AladdinBensaid/Aladdin_Flight_Controller/bottom_layer.png

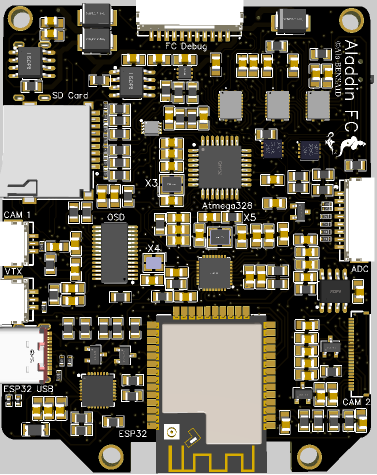
bottom_layer.png
