AladdinBensaid/Aladdin_Flight_Controller/block diagram.png

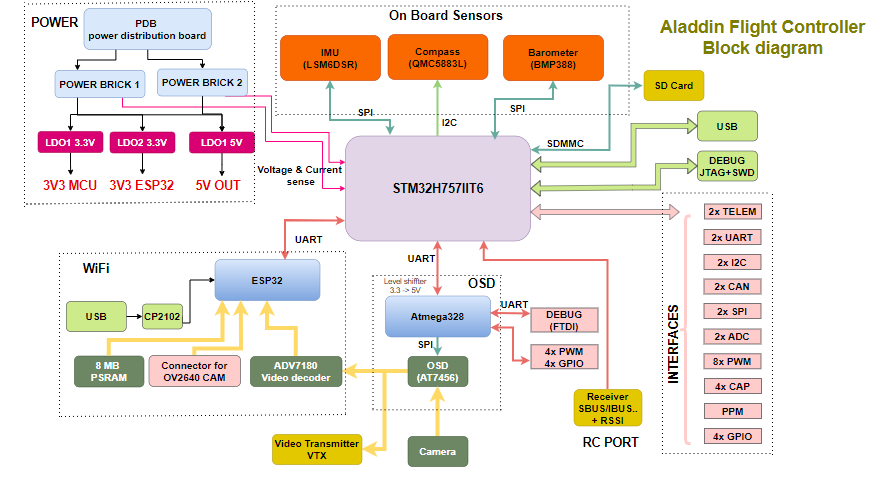
block diagram.png
