AladdinBensaid/Aladdin_Flight_Controller/top_layer.png

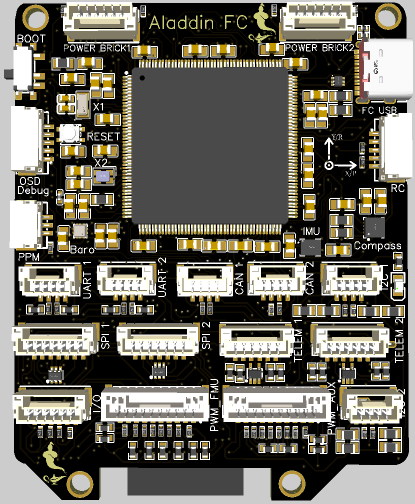
top_layer.png
