AladdinBensaid/Aladdin_Flight_Controller/BOM/BOM_Aladdin Flight Controller FC-H7_2023-02-08.csv

ID | Name | Designator | Footprint | Quantity | Manufacturer Part | Manufacturer | Supplier | Supplier Part | Price | link
1 | 100nF | C1,C2,C3,C4,C5,C6,C7,C8,C9,C10,C11,C12,C13,C14,C15,C16,C17,C18,C20,C21,C27,C28,C33,C36,C37,C38,C39,C40,C41,C45,C46,C47,C48,C51,C52,C53,C54,C56,C58,C59,C65,C68,C71,C72,C73,C74,C75,C89,C90,C91,C92,C93,C94,C95 | C0805 | 54 | CL21B104KBCNNNC | SAMSUNG | LCSC | C1711 | 0.001
2 | 4.7uF | C19,C22,C34 | C0805 | 3 | CL21B475KAFNNNE | SAMSUNG | LCSC | C98195 | 0.004
3 | 2.2uF | C23,C25 | C0805 | 2 | CS2012X5R225K500NRE | Samwha Capacitor | LCSC | C513763 | 0.004
4 | 1uF | C24,C26,C60,C61,C62,C67,C70,C86,C88 | C0805 | 9 | UMK212BJ105KG-T | Taiyo Yuden | LCSC | C319195 | 0.006
5 | 15pF | C29,C30 | C0603 | 2 | CL10C150JB8NNNC | SAMSUNG | LCSC | C1644 | 0.001
6 | 8pF | C31,C32 | C0805 | 2 | CL21C080DBANNNC | Samsung Electro-Mechanics | LCSC | C170111 | 0.006
7 | 220nF | C35 | C0805 | 1 | CC0805ZRY5V8BB224 | YAGEO | LCSC | C327192 | 0.004
8 | 10uF | C42,C55 | C0805 | 2 | TMK212BBJ106KGHT | Taiyo Yuden | LCSC | C386084 | 0.005
9 | 4pF | C43,C44 | C0805 | 2 | TCC0805C0G4R0C500BT | CCTC | LCSC | C282704 | 0.001
10 | 47uF | C49,C50 | C0805 | 2 | JMK212BJ476MG-T | TAIYO YUDEN | LCSC | C87159 | 0.006
11 | 15pF | C57 | C0805 | 1 | 0805CG150J500NT | FH | LCSC | C63339 | 0.001
12 | 47pF | C63,C64,C85 | C0805 | 3 | GCM21A5C2E470JX01D | muRata(村田) | LCSC | C440149 | 0.016 | https://atta.szlcsc.com/upload/public/pdf/source/20191022/C440149_79910CCEBA1A5070D97A60AC043D8869.pdf
13 | 82nF | C66 | C0805 | 1 | CC0805JRX7R9BB823 | YAGEO | LCSC | C520047 | 0.002
14 | 10nF | C69,C76,C77,C78,C79,C80 | C0805 | 6 | CC0805KRX7R9BB103 | YAGEO | LCSC | C83170 | 0.001
15 | 2.2uF | C81,C82,C83,C84 | C0805 | 4 | CC0805ZRY5V7BB225 | YAGEO | LCSC | C107171 | 0.005
16 | 22uF | C96 | C0805 | 1 | CL21A226MAQNNNE | SAMSUNG(三星) | LCSC | C45783 | 0.004
17 | XKTF-N02-G | CARD2 | TF-SMD_XKTF-N02-G | 1 | XKTF-N02-G | XKB Connectivity | LCSC | C1121875 | 0.025
18 | A1257WV-S-7P | CN1,CN2 | CONN-SMD_A1257WV-S-7P | 2 | A1257WV-S-7P | Changjiang Connectors | LCSC | C225123 | 0.038
19 | A1257WV-S-6P | CN3,CN4,CN5,CN15,CN17 | CONN-SMD_A1257WV-S-6P | 5 | A1257WV-S-6P | CJT(长江连接器) | LCSC | C225122 | 0.031
20 | A1257WV-S-4P | CN6,CN7,CN8,CN9,CN10,CN11 | CONN-SMD_A1257WV-S-4P | 6 | A1257WV-S-4P | CJT(长江连接器) | LCSC | C225120 | 0.019
21 | GH125-S10CCA-00 | CN14,CN16 | CONN-SMD_10P-P1.25_JS_GH125-S10CCA-00 | 2 | GH125-S10CCA-00 | JS(钜硕电子) | LCSC | C2886788 | 0.022
22 | A1257WR-S-3P | CN18,CN19,CN21 | CONN-SMD_A1257WR-S-3P | 3 | A1257WR-S-3P | Changjiang Connectors | LCSC | C225126 | 0.019
23 | A1257WR-S-5P | CN20,CN22 | CONN-SMD_A1257WR-S-5P | 2 | A1257WR-S-5P | Changjiang Connectors | LCSC | C225128 | 0.023
24 | A1257WR-S-8P | CN24 | CONN-SMD_A1257WR-S-8P | 1 | A1257WR-S-8P | CJT(长江连接器) | LCSC | C225131 | 0.031
25 | ST34BF | D1,D3,D14 | SMBF_L4.3-W3.6-LS5.3-RD | 3 | ST34BF | MDD（Microdiode Electronics） | LCSC | C414005 | 0.017
26 | SP1001-05JTG | D4,D5 | SC-70-6_L2.2-W1.3-P0.65-LS2.1-BL | 2 | SP1001-05JTG | Littelfuse | LCSC | C207268 | 0.112
27 | ESD9X5V-2/TR | D6,D7,D8,D9,D10,D11,D12,D13,D15,D18,D19,D20,D21,D22,D23,D24,D25,D26,D27,D28,D29,D30,D31,D32,D33,D34,D35,D36,D37,D38,D39,D40,D41,D42,D43,D44,D45,D46,D47,D48,D49,D50,D51,D52,D53,D54,D55,D56,D57,D58,D59,D60,D61,D62,D63,D64,D65 | FBP-02C_L1.0-W0.6-RD | 57 | ESD9X5V-2/TR | Will Semicon | LCSC | C239552 | 0.004
28 | SP1001-04JTG | D16,D17 | SC-70-5_L2.1-W1.3-P0.65-LS2.2-BR | 2 | SP1001-04JTG | Littelfuse | LCSC | C207267 | 0.073
29 | 0.5K-HX-24PWB | FPC1 | FPC-SMD_24P-P0.50_HDGC_0.5K-HX-24PWB | 1 | 0.5K-HX-24PWB | HDGC(华德共创) | LCSC | C2919499 | 0.045
30 | FCM1005KF-601T03 | L1 | L0402 | 1 | FCM1005KF-601T03 | TAI-TECH(台庆) | LCSC | C427432
31 | SZYY0805B | LED1 | LED0805-R-RD_BLUE | 1 | SZYY0805B | yongyu(永裕光电) | LCSC | C434433 | 0.002
32 | S8050_C105433 | Q3,Q4 | SOT-23-3_L2.9-W1.6-P1.90-LS2.8-BR | 2 | S8050 | CJ | LCSC | C105433 | 0.002
33 | 10kΩ | R1,R9,R21,R25,R26,R30,R31,R37,R38,R63 | R0805 | 10 | ARG05BTC1002 | Viking Tech | LCSC | C406725 | 0.004
34 | 2.2kΩ | R2,R3 | R0805 | 2 | AR05BTB2201 | Viking Tech | LCSC | C374634 | 0.019
35 | 100kΩ | R4,R5,R6,R7,R8,R39,R43,R44 | R0805 | 8 | ARG05BTC1003 | Viking Tech | LCSC | C406726 | 0.005
36 | 1kΩ | R10,R11,R12,R24,R28,R29 | R0805 | 6 | ARG05BTC1001 | Viking Tech | LCSC | C309081 | 0.005
37 | 75Ω | R13,R14 | R0805 | 2 | AR05BTDW0750 | Viking Tech | LCSC | C319469 | 0.007
38 | 200kΩ | R15 | R0805 | 1 | AR05BTDW2003 | Viking Tech | LCSC | C319784 | 0.006
39 | 4.7kΩ | R16,R17,R18,R27,R36,R64 | R0805 | 6 | RMC08054.7K1%N | Tyohm | LCSC | C269746 | 0.001
40 | 5.1kΩ | R19,R20,R47,R48 | R0402 | 4 | RMC04025.1K5%N | Tyohm | LCSC | C325524
41 | 1MΩ | R22 | R0805 | 1 | AR05BTCW1004 | Viking Tech | LCSC | C316223 | 0.006
42 | 1.69kΩ | R23 | R0805 | 1 | ARG05FTC1691 | Viking Tech | LCSC | C218401 | 0.002
43 | 4kΩ | R32 | R0805 | 1 | ARG05FTC4001N | 光颉(Viking) | LCSC | C2828855 | 0.001
44 | 0Ω | R33,R42,R62,R65,R86,R88,R89,R90,R91 | R0805 | 9 | 0805W8F0000T5E | UniOhm | LCSC | C17477
45 | 36Ω | R34 | R0805 | 1 | AECR0805F36R0K9 | ResistorToday | LCSC | C352217 | 0.001
46 | 39 | R35 | R0805 | 1 | AC0805JR-0739RL | YAGEO | LCSC | C229199 | 0.001
47 | 50Ω | R40 | R0805 | 1 | ARG05FTC0500 | 光颉(Viking) | LCSC | C2828866 | 0.002
48 | 300kΩ | R41,R92 | R0805 | 2 | ERJ6GEYJ304V | PANASONIC | LCSC | C410067 | 0.001
49 | 120 | R45,R46 | R0805 | 2 | AC0805FR-07120RL | YAGEO | LCSC | C228277 | 0.001
50 | 1.5K | R49,R50,R51,R52 | R0805 | 4 | CR0805-FX-1501ELF | BOURNS | LCSC | C203762 | 0.002
51 | 22 | R53,R54,R55,R56 | R0805 | 4 | CR0805-FX-22R0ELF | BOURNS | LCSC | C204317 | 0.002
52 | 100Ω | R57,R58,R59,R60,R61,R66,R67,R68,R69,R70,R71,R72,R73,R74,R75,R76,R77,R78,R79,R80,R81,R82,R83,R84,R85 | R0603 | 25 | FRC0603J101 TS | FOJAN(富捷) | LCSC | C2907089
53 | RC0805DR-0780K6L | R93 | R0805 | 1 | RC0805DR-0780K6L | YAGEO(国巨) | LCSC | C472215 | 0.002
54 | TS-3027-B | SW1 | SW-SMD_4P-L3.0-W2.8-P1.65-TL_GT-TS171A-H014-L1 | 1 | TS-3027-B | XKB Enterprise | LCSC | C561482 | 0.025
55 | MK-12C02-G025 | SW2 | SW-SMD_MK-12C02-G025 | 1 | MK-12C02-G025 | G-Switch | LCSC | C778186 | 0.02
56 | STM32H757IIT6 | U1 | LQFP-176_L24.0-W24.0-P0.50-LS26.0-BL | 1 | STM32H757IIT6 | STMicroelectronics | LCSC | C730215 | 4.025
57 | BMP388 | U2 | SENSORM-SMD_BMP388 | 1 | BMP388 | null | LCSC | C779278 | 0.437
58 | QMC5883L | U3 | LGA-16_L3.0-W3.0-P0.50-BL_SQ | 1 | QMC5883L | QST(上海矽睿) | LCSC | C976032 | 0.22
59 | LSM6DSOWTR | U4 | LGA-14L_L3.0-W2.5-P0.50-TL | 1 | LSM6DSOWTR | ST(意法半导体) | LCSC | C2829074 | 0.442 | https://atta.szlcsc.comnull
60 | ATMEGA328P-AU | U5 | TQFP-32_L7.0-W7.0-P0.80-LS9.0-BL | 1 | ATMEGA328P-AU | MICROCHIP | LCSC | C14877 | 0.481
61 | AT7456E | U6 | TSSOP-28_L9.7-W4.4-P0.65-LS6.4-BL-EP-2 | 1 | AT7456E | ZHONGKEWEI | LCSC | C82351 | 0.48
62 | PCA9306DCUR | U7 | SSOP-8_L2.0-W2.3-P0.50-LS3.1-BR | 1 | PCA9306DCUR | TI | LCSC | C33196 | 0.05
63 | ME6211A12M3G-N | U8 | SOT-23-3_L2.9-W1.6-P1.90-LS2.8-BR | 1 | ME6211A12M3G-N | Nanjing Micro One Elec | LCSC | C236678 | 0.011
64 | LY68L6400SLIT | U9 | SOP-8_L4.9-W3.9-P1.27-LS6.0-BL | 1 | LY68L6400SLIT | Lyontek Inc. | LCSC | C261881 | 0.478
65 | USB-TYPE-C-017 | U10,U23 | USB-TYPE-C-SMD_C9900008089_ALA1 | 2 | USB-TYPE-C-017 | DEALON(德艺隆) | LCSC | C2927037 | 0.023 | https://atta.szlcsc.com/upload/public/pdf/source/20211217/653222EE5174722C9DFE2966329956D8.pdf
66 | XC6206-2.8V | U11 | SOT-23-3_L2.9-W1.6-P1.90-LS2.8-BR | 1 | XC6206-2.8V | YONGYUTAI(永裕泰) | LCSC | C2892669 | 0.008
67 | CP2102-GMR | U12 | WQFN-28_L5.0-W5.0-P0.50-BL-EP3.2 | 1 | CP2102-GMR | SILICON LABS | LCSC | C6568 | 0.39
68 | ESP32-S(8MB) | U13 | WIRELM-SMD_ESP32-S | 1 | ESP32-S(8MB) | Ai-Thinker(安信可) | LCSC | C2991922 |  | https://atta.szlcsc.com/upload/public/pdf/source/20211217/F4BEA33E732D6002D10DAED85BBCB52B.pdf
69 | MF-NSMF150-2 | U14 | F1206 | 1 | MF-NSMF150-2 | BOURNS | LCSC | C89655 | 0.006
70 | 65K5. | U15 | SOT-23-3_L2.9-W1.3-P1.90-LS2.4-BR | 1 | 65K5. | Shenzhen Fuman Elec | LCSC | C841299 | 0.008
71 | ADV7180BCP32Z-RL | U16 | LFCSP-32_L5.0-W5.0-P0.50-BL-EP3.6 | 1 | ADV7180BCP32Z-RL | Analog Devices | LCSC | C459884 | 0.533
72 | TJA1051TK/3,118 | U17,U21 | HVSON-8_L3.0-W3.0-P0.65-BL-EP | 2 | TJA1051TK/3,118 | NXP | LCSC | C124020 | 0.25
73 | LR1801G-33-SH2-R | U19,U20 | HSOP-8_L5.0-W4.0-P1.27-LS6.2-BL-EP | 2 | LR1801G-33-SH2-R | Unisonic Tech | LCSC | C410479 | 0.021
74 | NUF2042XV6T1G | U22 | SOT-563_L1.6-W1.2-P0.50-LS1.6-TL | 1 | NUF2042XV6T1G | ON Semicon | LCSC | C90707 | 0.08
75 | TPS25200DRVR | U24 | WSON-6_L2.0-W2.0-P0.65-TL-EP | 1 | TPS25200DRVR | TI | LCSC | C128401 | 0.128
76 | TXS0108ERGYR | U25,U26,U29 | VQFN-20_L4.6-W3.6-P0.50-BL-EP | 3 | TXS0108ERGYR | TI(德州仪器) | LCSC | C90706 | 0.403
77 | A1257WR-S-11P | U27 | CONN-SMD_A1257WR-S-11P | 1 | A1257WR-S-11P | Changjiang Connectors | LCSC | C272991 | 0.047
78 | 32.768kHz | X1 | OSC-SMD_2P-L3.2-W1.5 | 1 | CM315D32768DZFT | CITIZEN | LCSC | C182057 | 0.043
79 | 24MHz | X2 | OSC-SMD_4P-L2.0-W1.6-BL | 1 | TZ1620C | TST | LCSC | C498196 | 0.03
80 | 16MHz | X3 | CRYSTAL-SMD_4P-L3.2-W2.5-BL | 1 | X1E0003410273 | Seiko Epson | LCSC | C255906 | 0.076
81 | 27MHz | X4 | OSC-SMD_4P-L2.5-W2.0-BL | 1 | Q24FA20H00238 | Seiko Epson | LCSC | C255960 | 0.042
82 | 28.63636MHz | X5 | CRYSTAL-SMD_4P-L3.2-W2.5-BL | 1 | 7B028636R01 | HD | LCSC | C655017 | 0.016
