AladdinBensaid/Aladdin_Flight_Controller/3d parts/top_part_enclosure_3d.STL

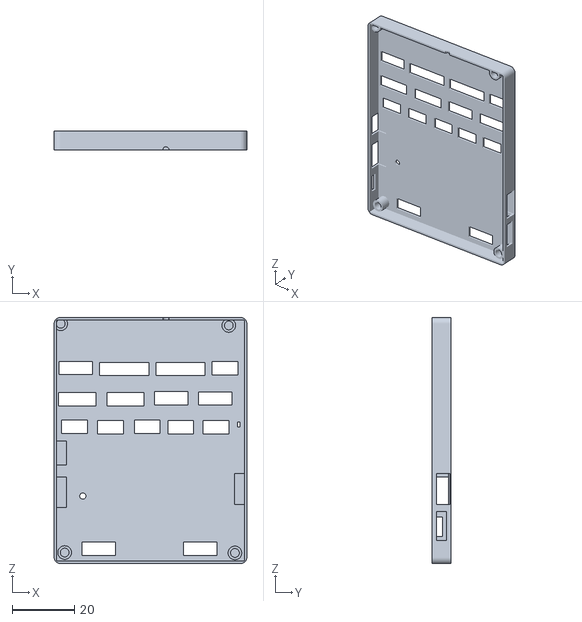
[picture p4: CAD file, 2023-04-13]
3d parts/top_part_enclosure_3d.STL
61.9 x 6.00 x 79.0
