AladdinBensaid/Aladdin_Flight_Controller/3d parts/bottom_part_enclosure.SLDPRT

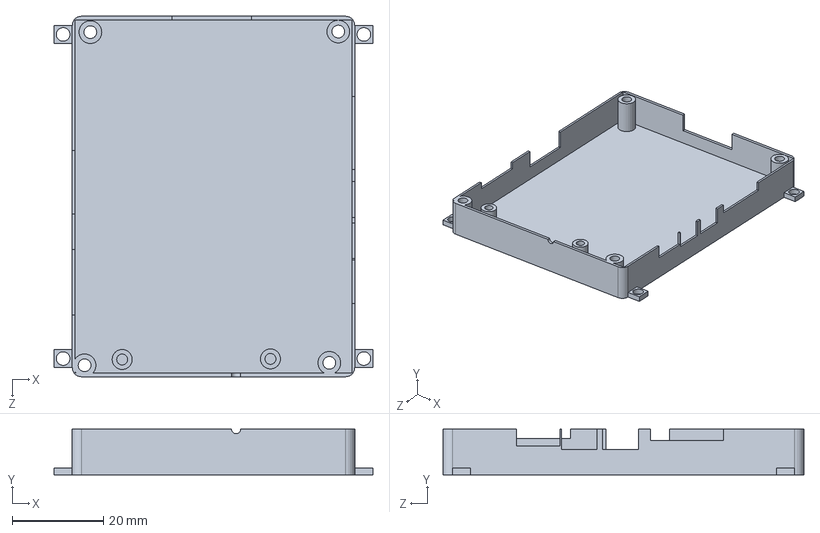
[picture p5: CAD file, 2023-04-13]
3d parts/bottom_part_enclosure.SLDPRT
69.9 x 10.0 x 79.1 mm
