AladdinBensaid/Aladdin_Flight_Controller/(list of files, cad)

Other CAD files:
3d parts/bottom_part_enclosure_3d.STL
3d parts/top_part_enclosure.SLDPRT
