AladdinBensaid/Aladdin_Flight_Controller/Aladdin_Flight_Controller_Manual.pdf

# Aladdin Flight Controller

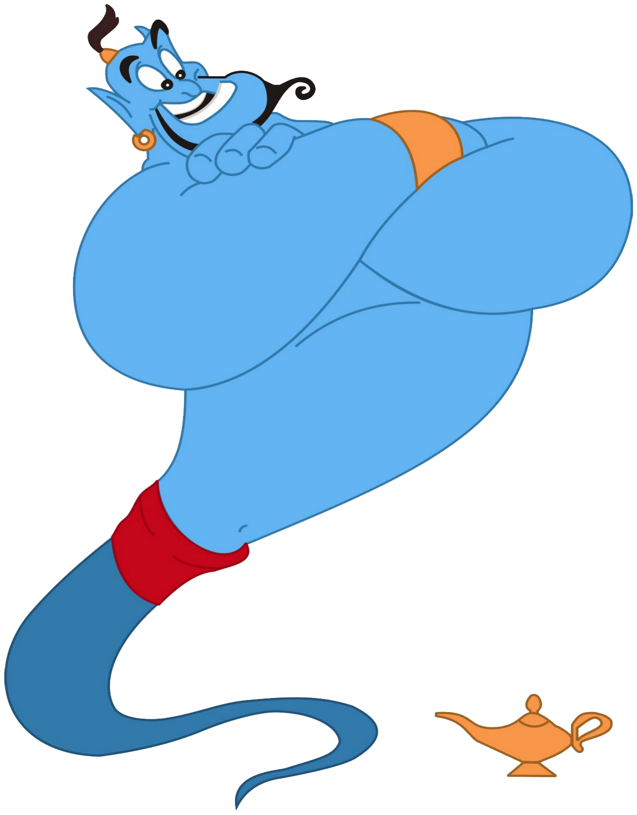
[picture p6: figure]

©Ala bensaid
Github : AladdinBensaid

Aladdin FC is an advanced STM32H7 autopilot designed by Ala bensaid.

Specifications :

Processor :
- Dual 32 bit ARM Cortex M7/M4 with double precision FPU (STM32H757)
- 480Mhz / 1 MB RAM / 2 MB Flash
- 8 bit IO MCU Co-Processor (Atmega328p)

Sensors :
- Barometer BMP388
- Magnetometer QMC5883L
- Accelerometer/Gyroscope LSM6DSOWTR

Power :
- USB input
- Operatory power 5V (dual power port)
- Dual voltage and current monitor inputs
- Adaptable with Pixhawk 4 power module PM07

Interfaces :
- 8-12 PWM output (8 FMU + 4 IO MCU) support DMA
- 2x CAN Bus
- 2x I2C Port
- 2x SPI Port
- 4x UART Port
- PPM Port
- RC Port Support all RC protocols including (SBUS/DSM/IBUS/PPM) + RSSI input
- 2x ADC pin
- I/O (4x GPIO)
- STM32 debug (JTAG + SWD + 1x UART) + USB interface
- IO MCU debug (1x UART)
- ESP32 USB interface

Others :
- Built in OSD
- SD Card (SDMMC protocol)
- ESP32 (8MB PSRAM) to support WiFi connectivity (live streaming / 4g,5g navigation …)
- Support Analog Camera (PAL/NTSC) + built in Analog to 8-bit video decoder
- Support OV2640 Camera
- Dimensions : 60.79mm x 76.71mm x 1.6mm
- JST GH connectors

Github Link for the project : https://github.com/AladdinBensaid/Aladdin_Flight_Controller

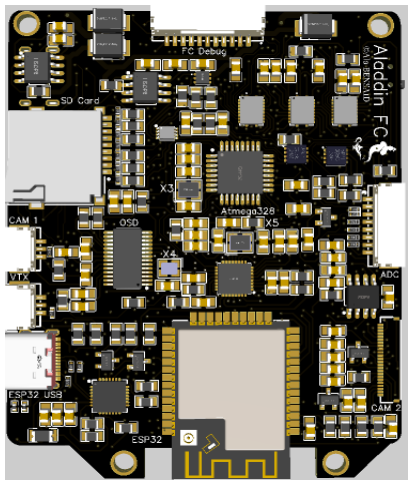
[picture p7: figure]
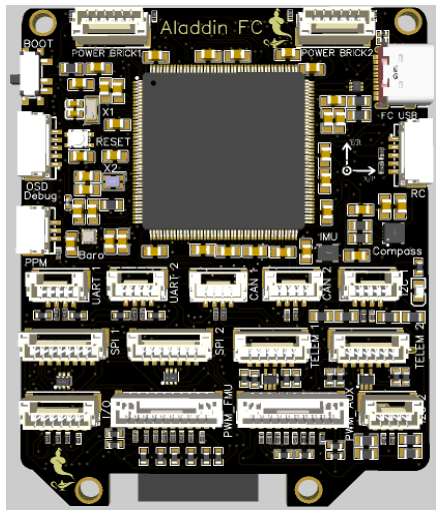
[picture p8: figure]

Top layer | Bottom layer

Aladdin FC Block Diagram

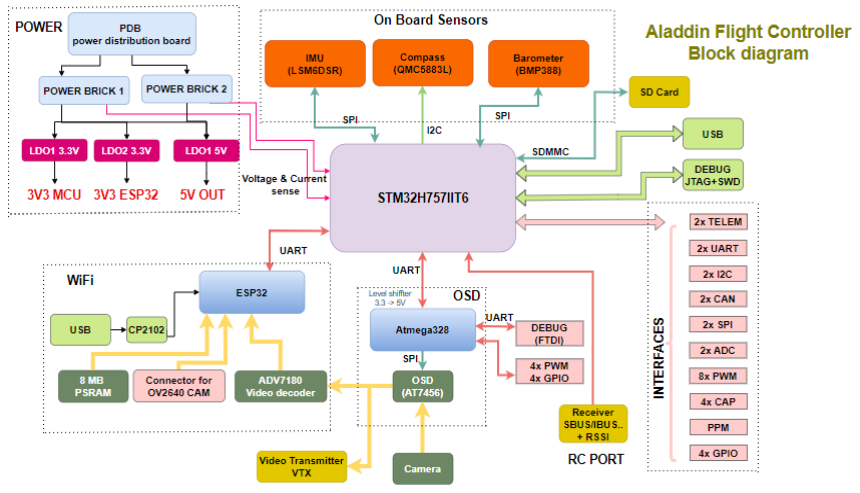
[picture p9: figure]

Connectors :
(Number of pin on board from left ->right / up -> down)
POWER BRICK 1 | POWER BRICK 2

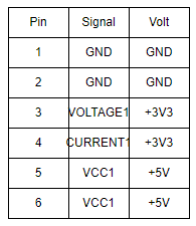
[picture p10: figure]
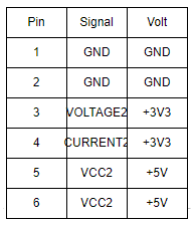
[picture p11: figure]
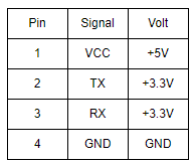
[picture p12: figure]
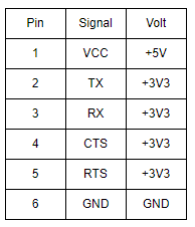
[picture p13: figure]

UART1 / UART2 | TELEM 1 / TELEM 2

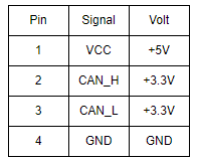
[picture p14: figure]
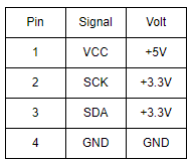
[picture p15: figure]

CAN 1/ CAN 2 | I2C 1 / I2C 2

SPI 1 / SPI 2

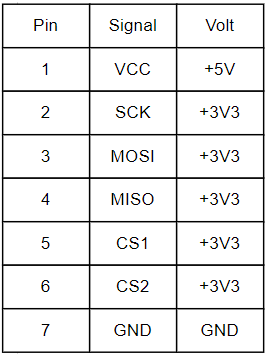
[picture p16: figure]
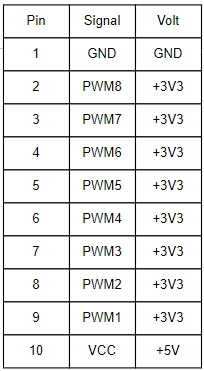
[picture p17: figure]
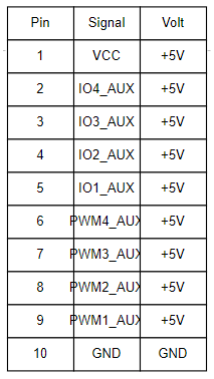
[picture p18: figure]

PWM FMU | PWM AUX

I/O

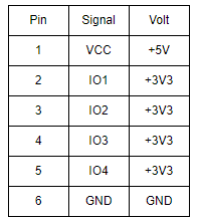
[picture p19: figure]
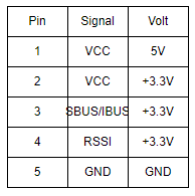
[picture p20: figure]
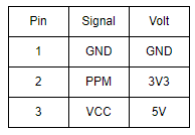
[picture p21: figure]

RC | PPM

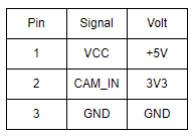
[picture p22: figure]
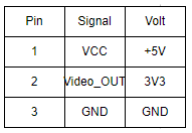
[picture p23: figure]

CAM | VTX

ADC | FC DEBUG

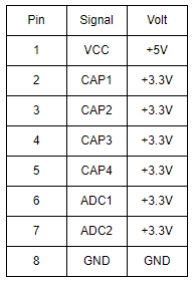
[picture p24: figure]

OSD DEBUG

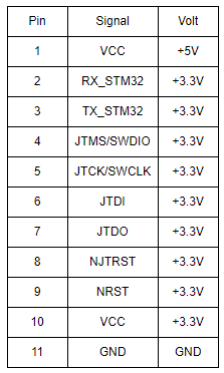
[picture p25: figure]
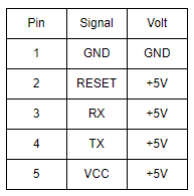
[picture p26: figure]

Aladdin FC schematics :

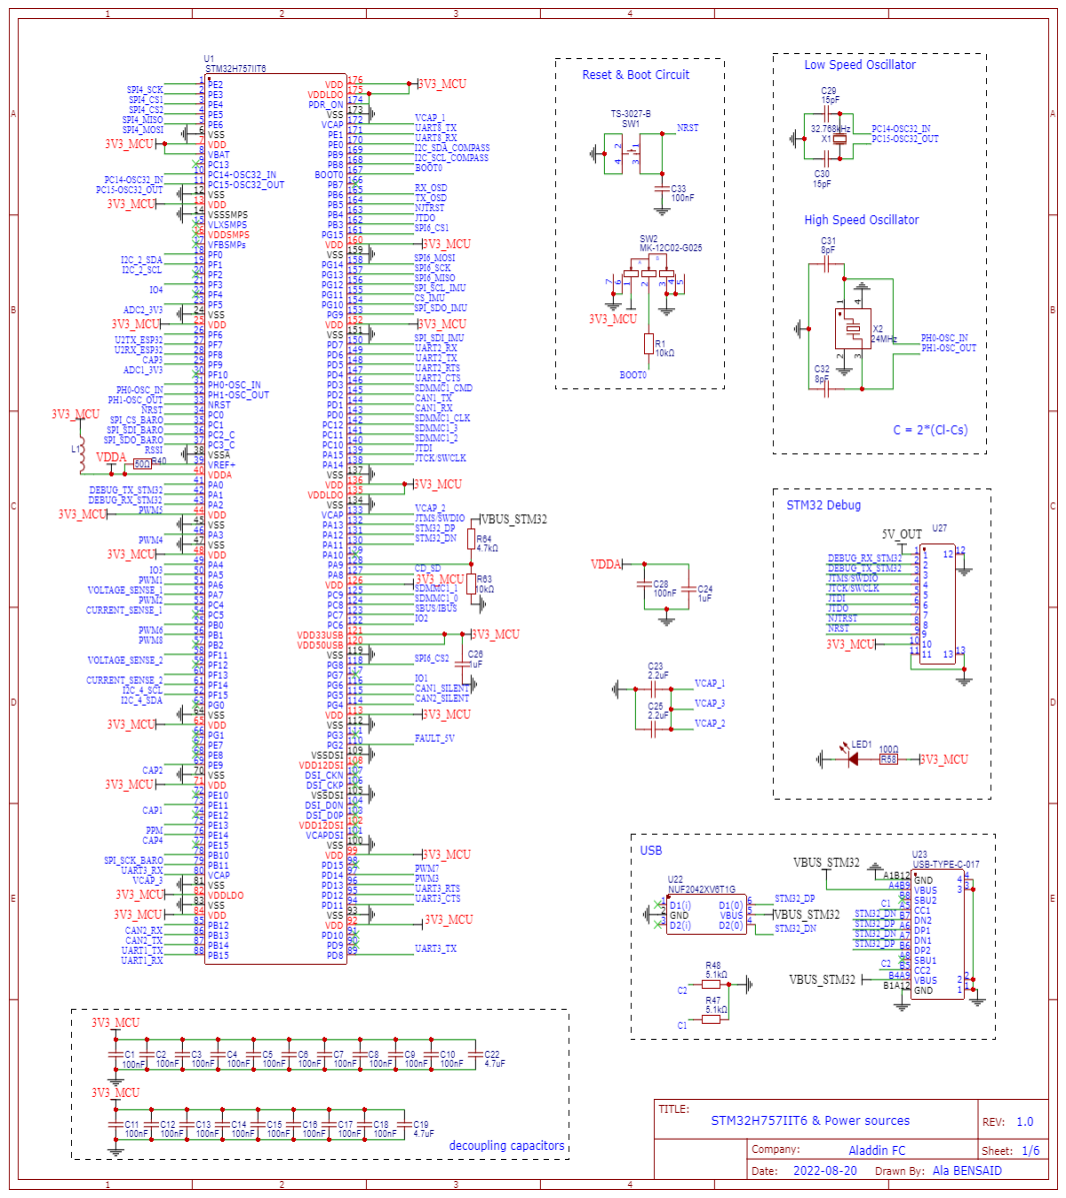
[picture p27: figure]
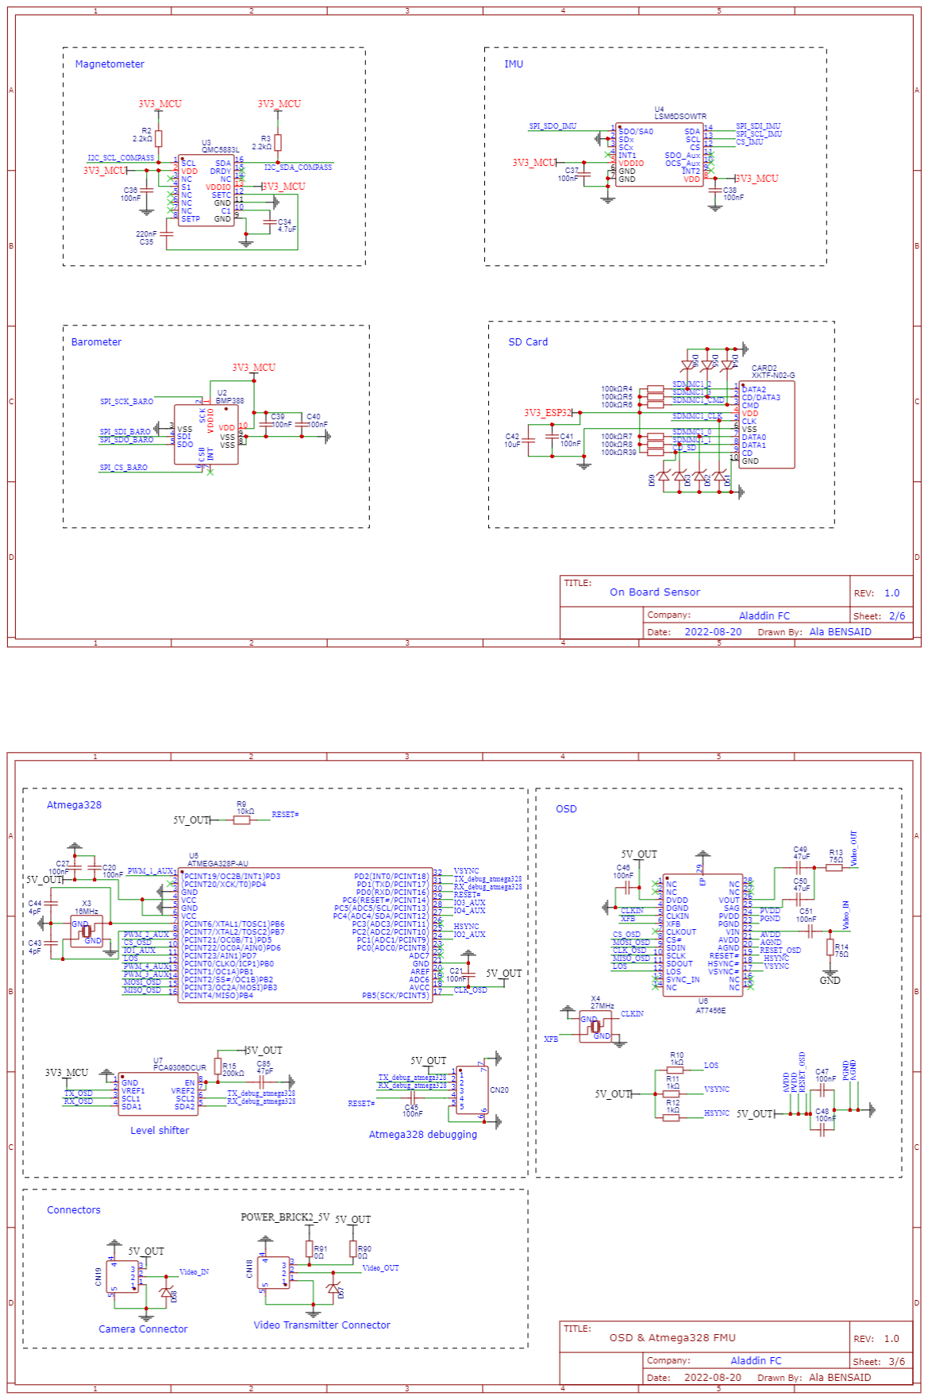
[picture p28: page 10]
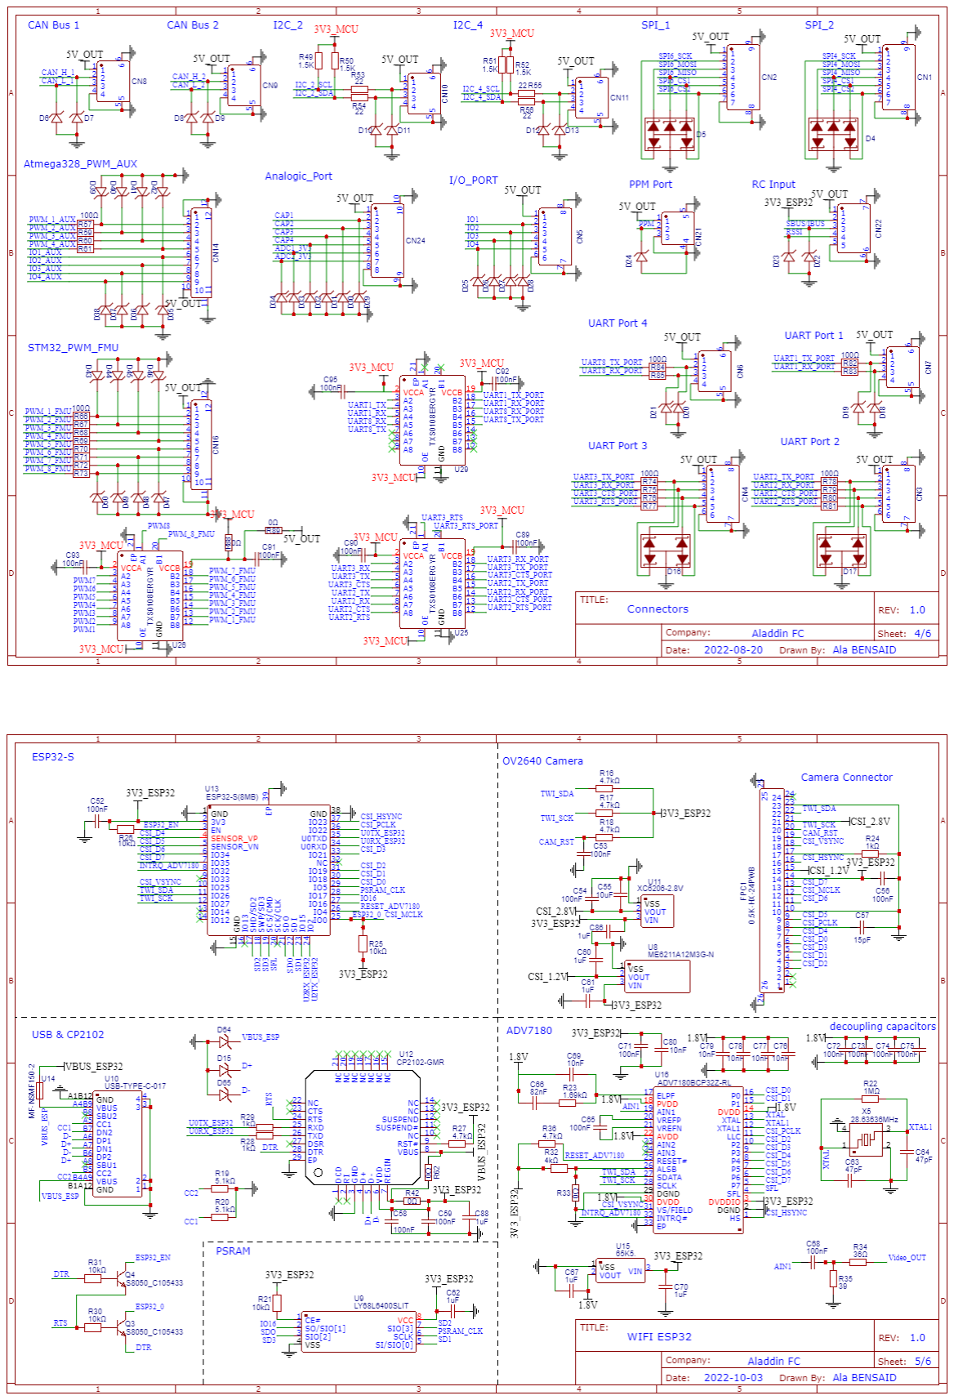
[picture p29: page 11]

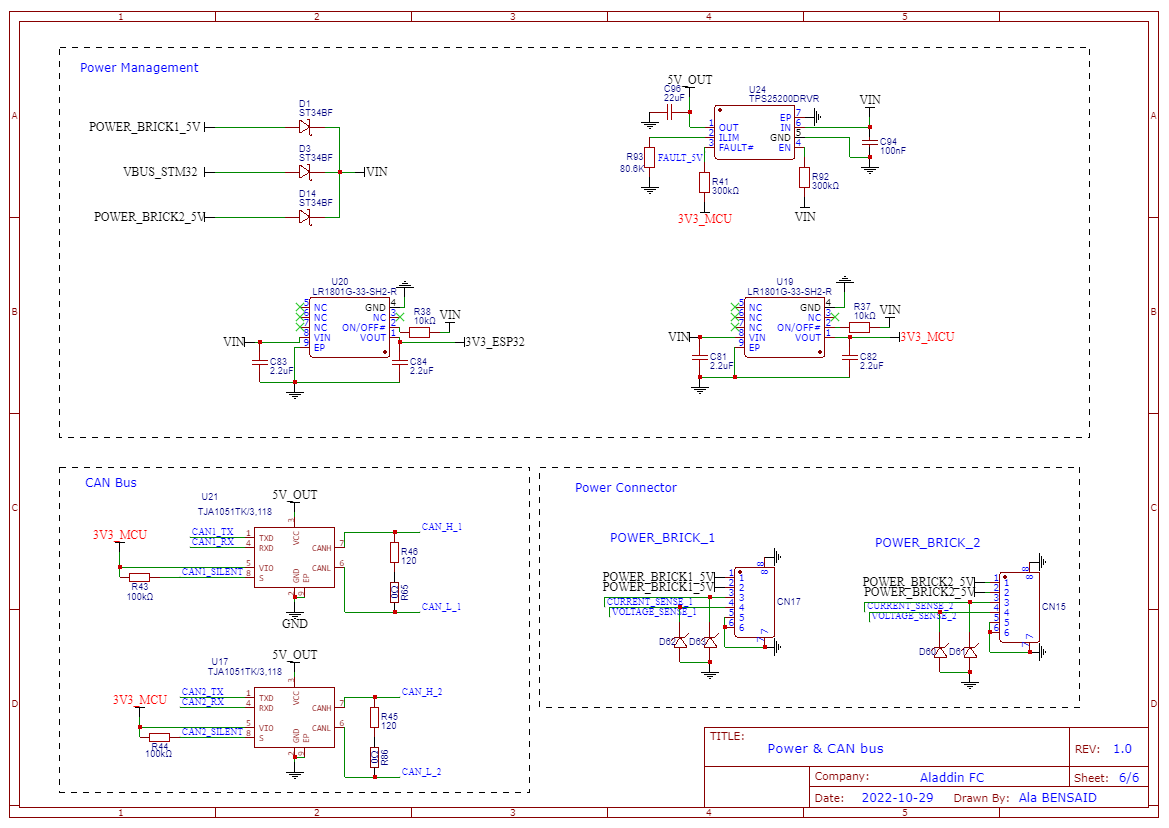
[picture p30: figure]

Aladdin FC is a 6 layers board with the following Stackup ;

1st layer (signals) + 2nd layer (GND Plane) + 3rd layer (signals + power) + 4th layer (signals) + 5th layer (GND plane) + 6th layer (signals)

1st layer (Top layer) layout :

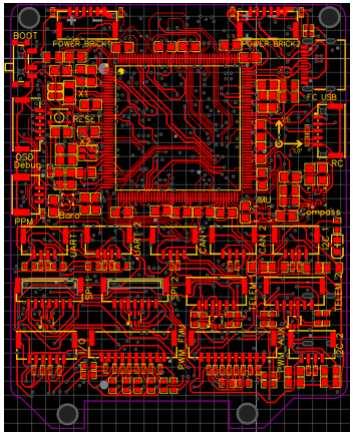
[picture p31: figure]

3rd layer layout

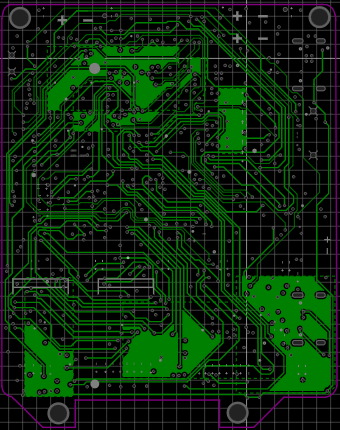
[picture p32: figure]

4th layer layout

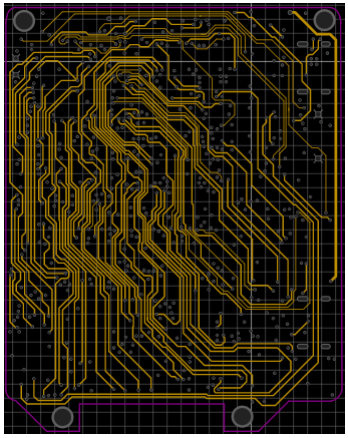
[picture p33: figure]

6th layer (Bottom layer) layout :

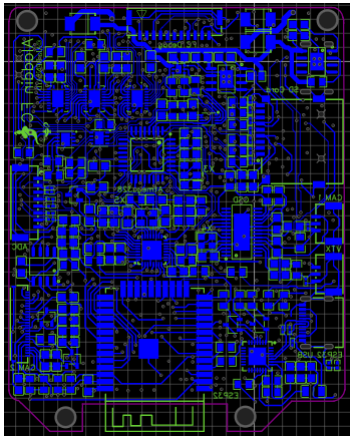
[picture p34: figure]
