AladdinBensaid/Aladdin_Flight_Controller/3d parts/assembly_pic.png

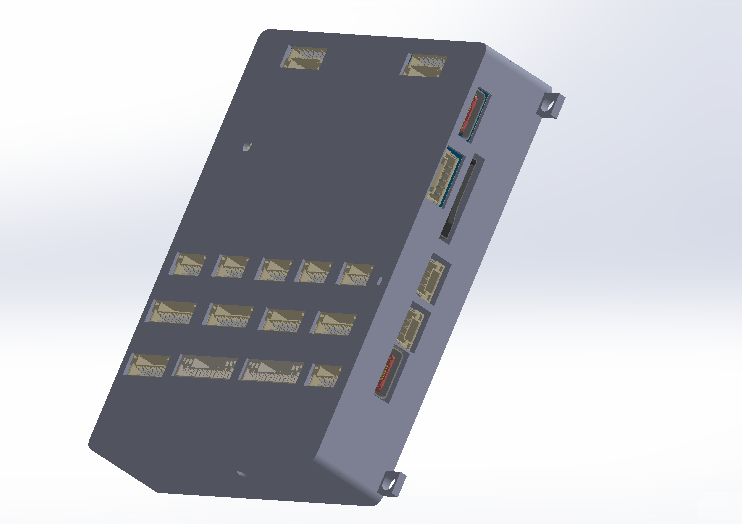
3d parts/assembly_pic.png
