AladdinBensaid/Aladdin_Flight_Controller/Schematic_Aladdin Flight Controller FC-H7.pdf

PB15 88 PD8 89 PD9 90 PD10 91 VDD 92 VSS 93 PD11 94 PD12 95 PD13 96 PD14 97 PD15 98 VDD 99 VSS 100 VCAPDSI 101 VDD12DSI 102 DSI_D0P 103 DSI_D0N 104 VSSDSI 105 DSI_CKP 106 DSI_CKN 107 VDD12DSI 108 VSSDSI 109 PG2 110 PG3 111 VSS 112 VDD 113 PG4 114 PG5 115 PG6 116 PG7 117 PG8 118 VSS 119 VDD50USB 120 VDD33USB 121 PC6 122 PC7 123 PC8 124 PC9 125 VDD 126 PA8 127 PA9 128 PA10 129 PA11 130 PA12 131 PA13 132 VCAP 133 VSS 134 VDDLDO 135 VDD 136 VSS 137 PA14 138 PA15 139 PC10 140 PC11 141 PC12 142 PD0 143 PD1 144 PD2 145 PD3 146 PD4 147 PD5 148 PD6 149 PD7 150 VSS 151 VDD 152 PG9 153 PG10 154 PG11 155 PG12 156 PG13 157 PG14 158 VSS 159 VDD 160 PG15 161 PB3 162 PB4 163 PB5 164 PB6 165 PB7 166 BOOT0 167 PB8 168 PB9 169 PE0 170 PE1 171 VCAP 172 VSS 173 PDR_ON 174 VDDLDO 175 VDD 176

## Reset & Boot Circuit

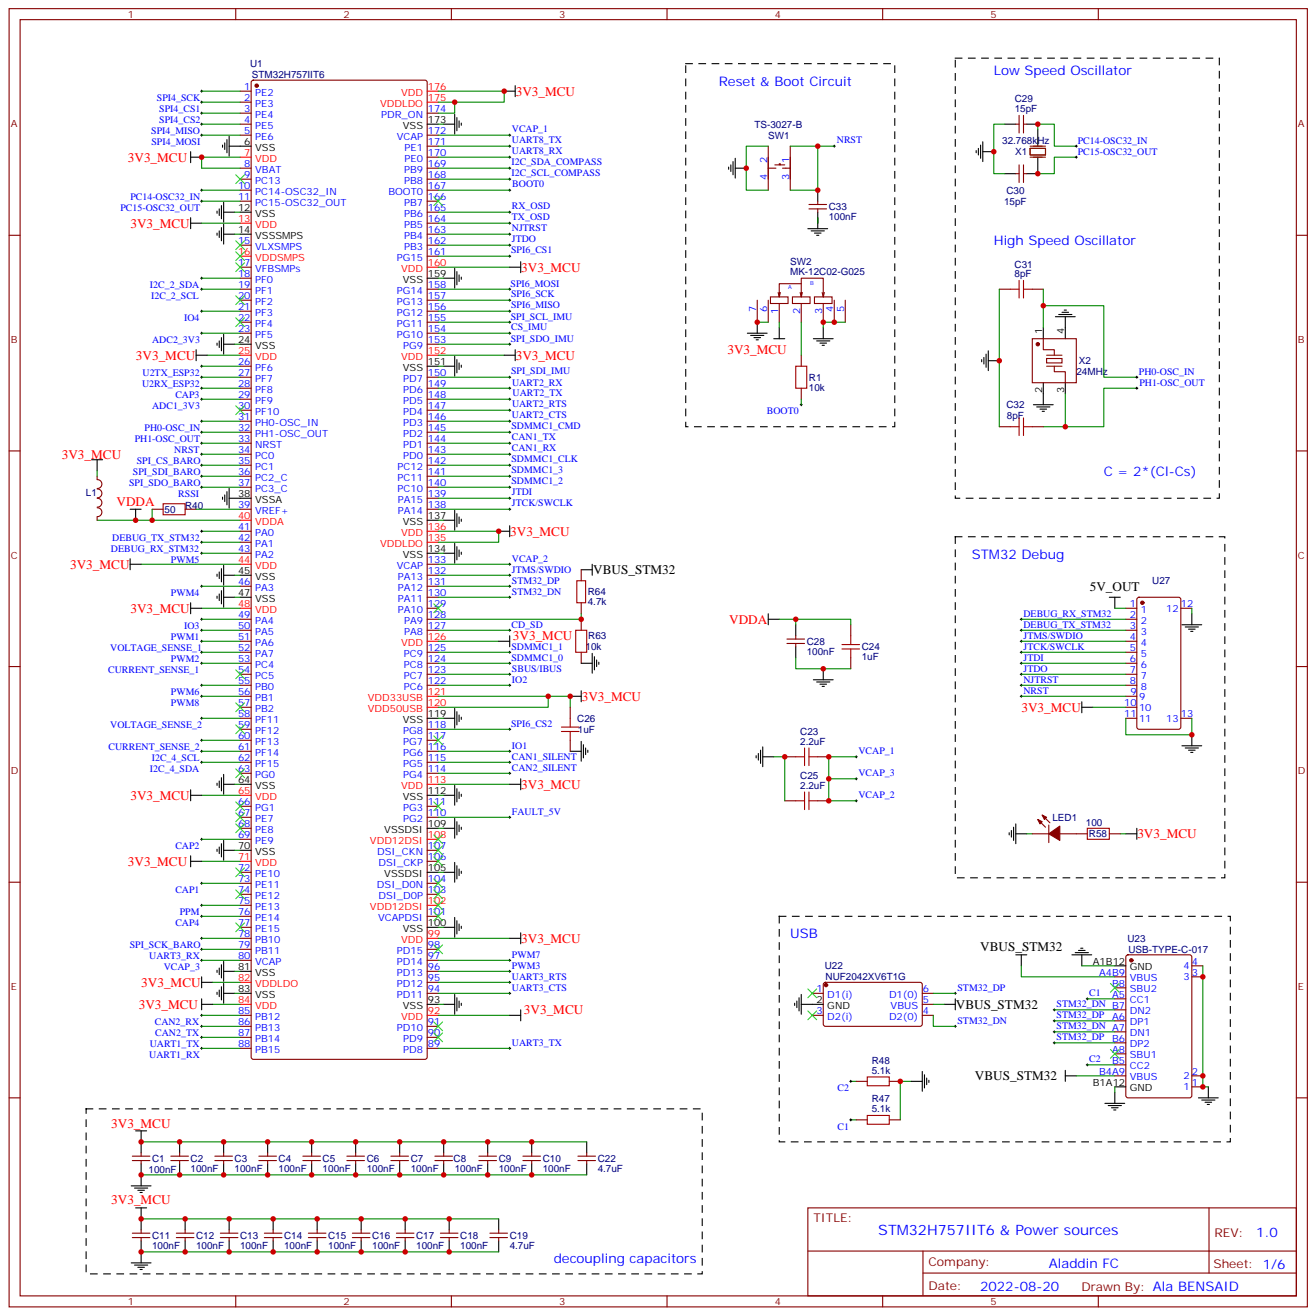
[picture p36: page 1]

Aladdin FC
Drawn By: Ala BENSAID

## Magnetometer

## IMU

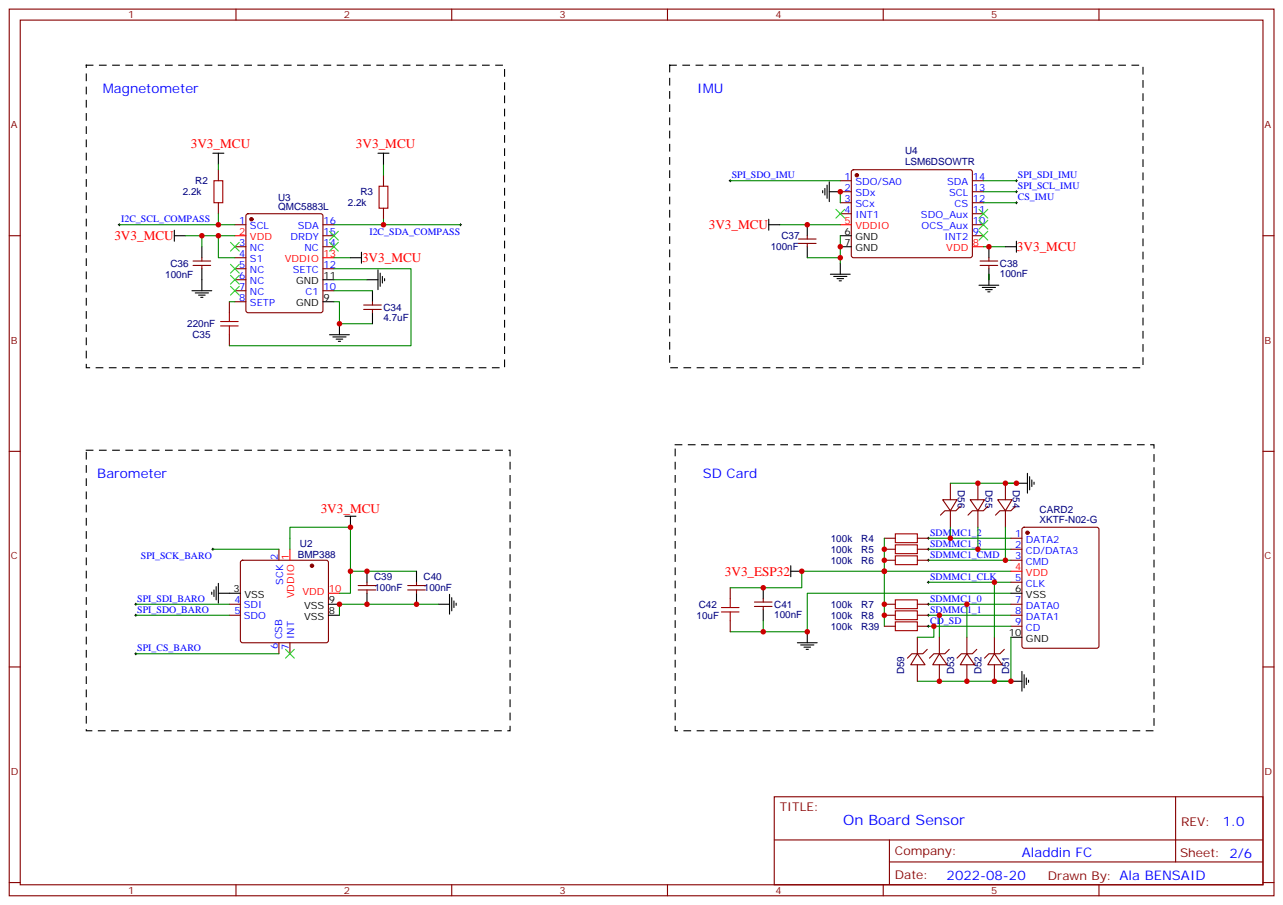
[picture p37: page 2]

QMC5883L
C1 10 GND 11 SETC 12 VDDIO 13 NC 14 DRDY 15 SDA 16

## OSD

## Atmega328

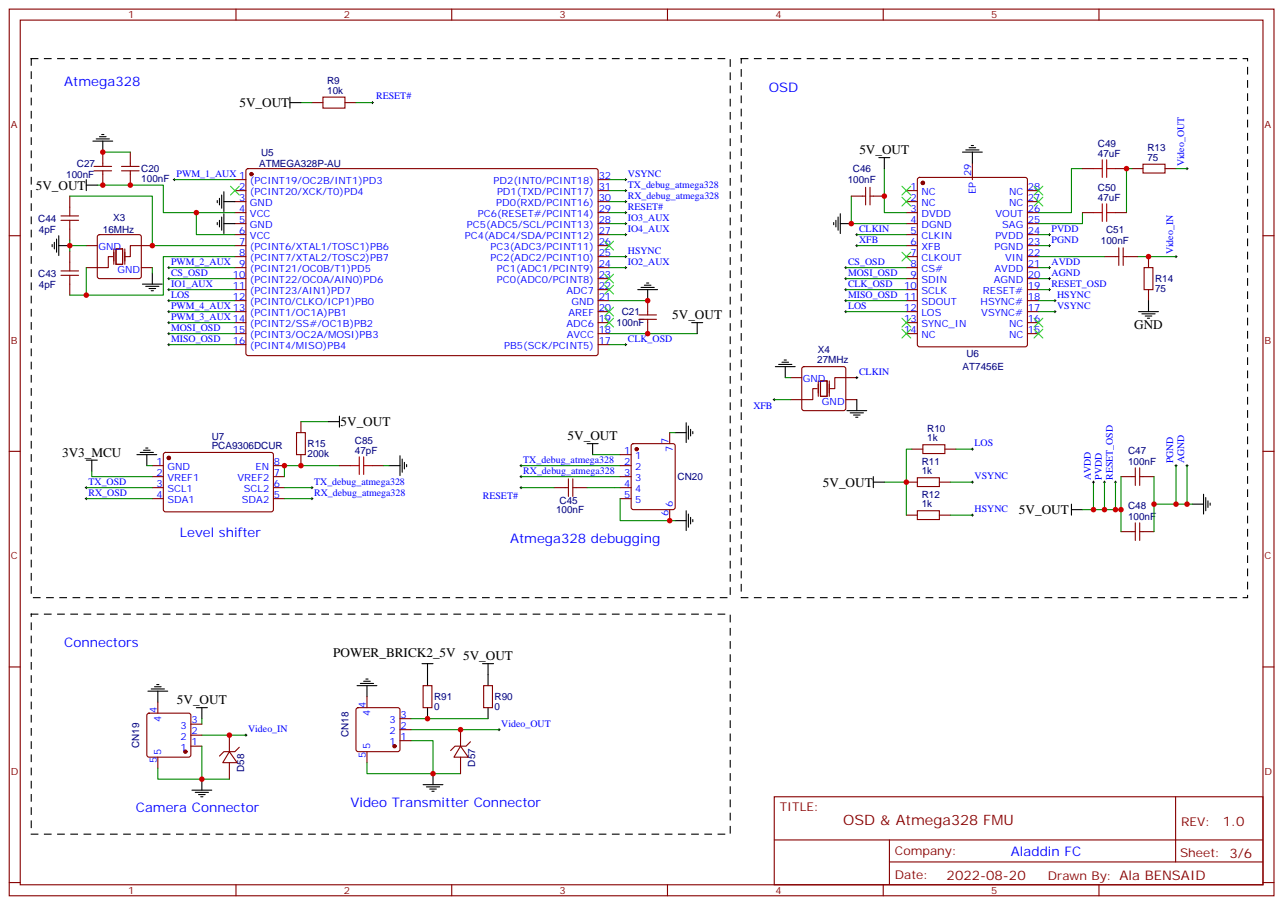
[picture p38: page 3]

CAN Bus 1 | CAN Bus 2
I2C_2 | I2C_4

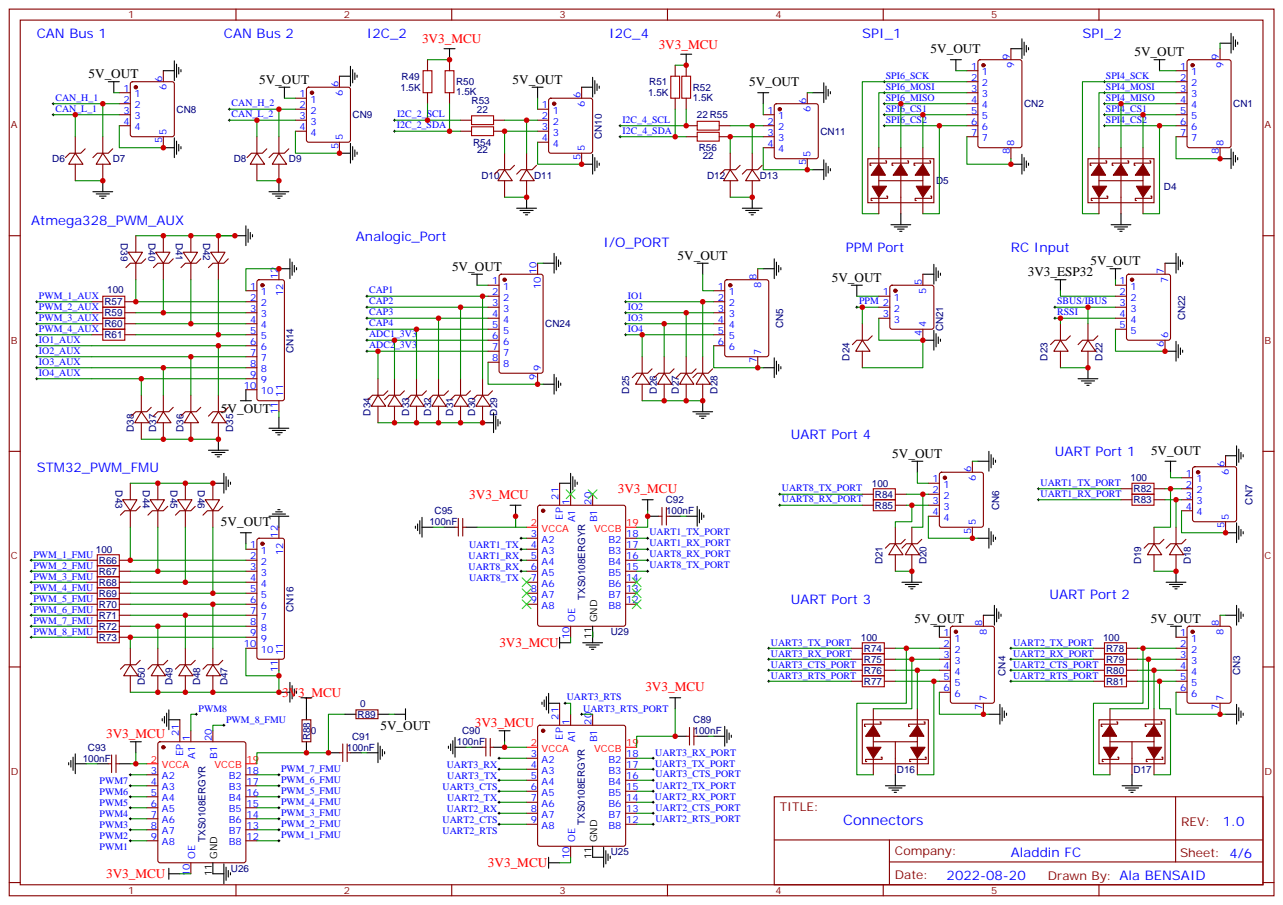
[picture p39: page 4]

## Camera Connector

## ESP32-S

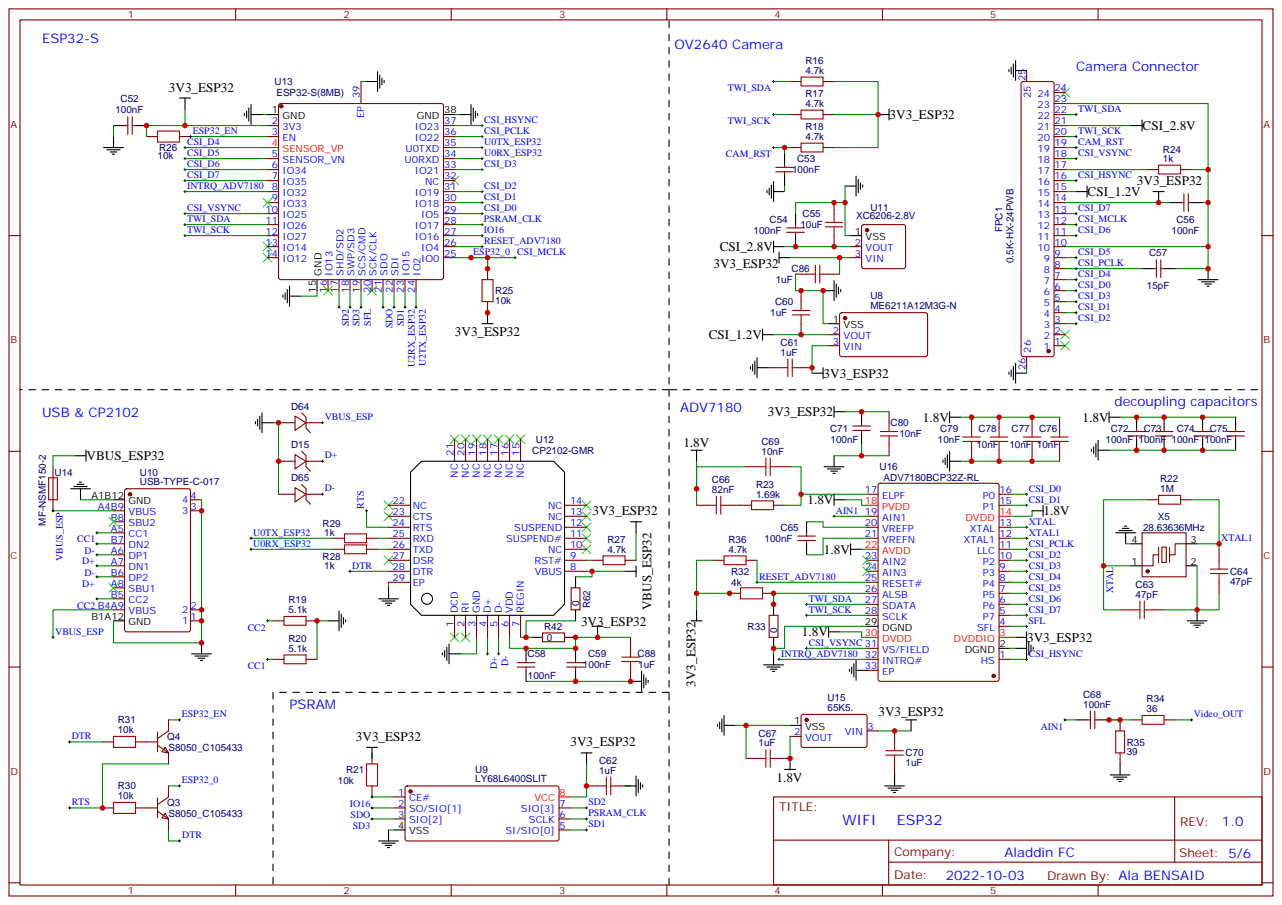
[picture p40: page 5]

IO2 24 IO15 23 SDI 22 SDO 21 SCK/CLK 20 SCS/CMD 19 SWP/SD3 18 SHD/SD2 17 IO13 16 GND 15

NC 10 SUSPEND# 11 SUSPEND 12 NC 13 NC 14 NC 15 NC 16 NC 17 NC 18 NC 19 NC 20 NC 21

## Power Management

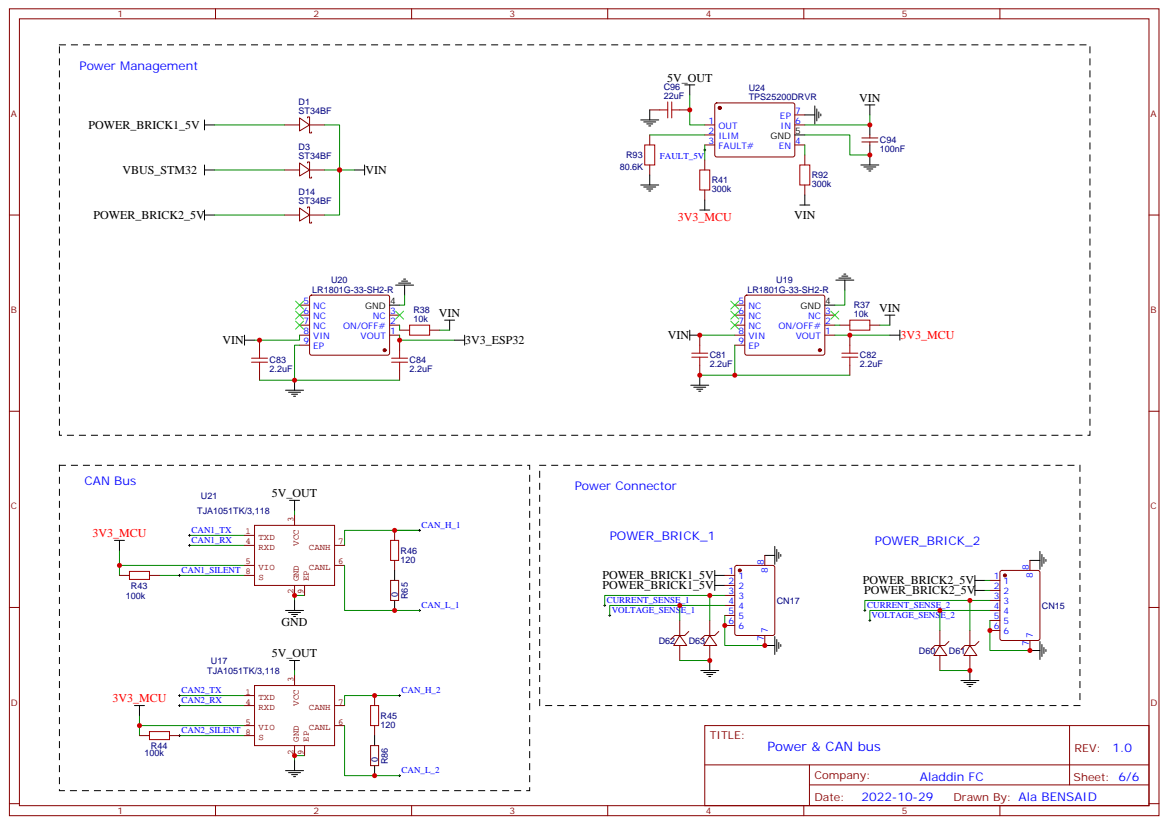
[picture p41: page 6]
