AladdinBensaid/Aladdin_Flight_Controller/Project_files/PCB_PCB_Aladdin Flight Controller FC-H7_2023-02-08 (1).pdf

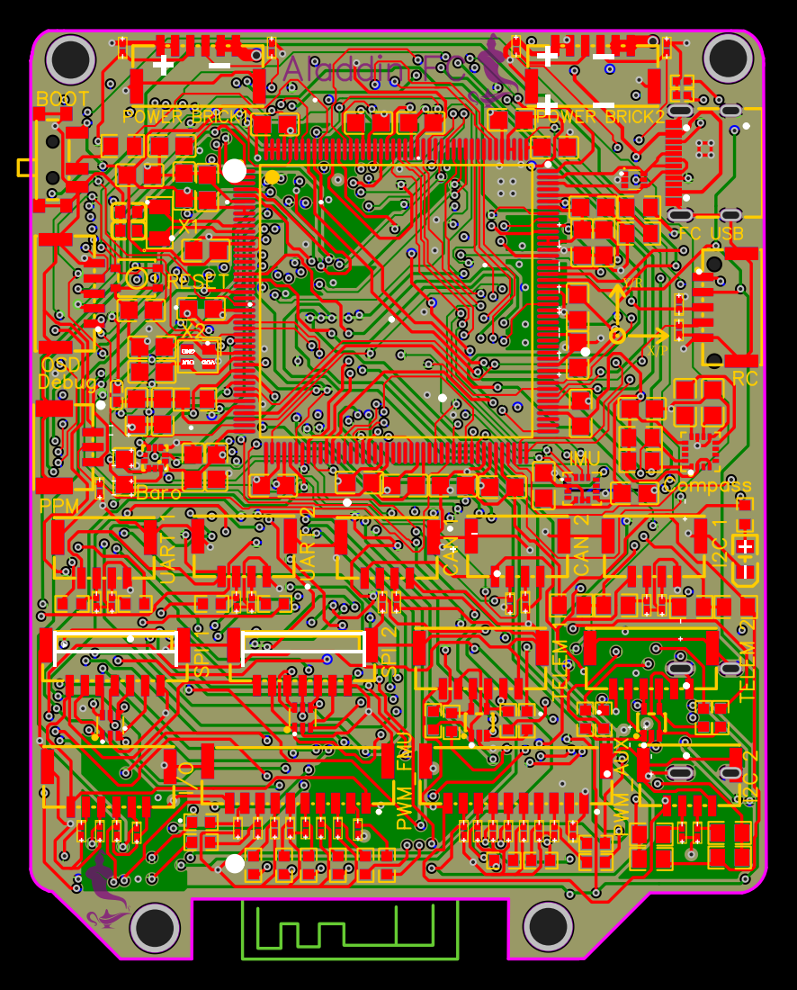
[picture p42: page 1]
