AladdinBensaid/Aladdin_Flight_Controller/(list of files, drawings)

Other design files:
Project_files/SCH_Aladdin Flight Controller FC-H7_EasyEDA.json
schematic/SCH_Aladdin Flight Controller FC-H7_2023-02-08.json
