AladdinBensaid/Aladdin_Flight_Controller/(commit log)

2023-02-08 first push
    [BOM_Aladdin Flight Controller FC-H7_2023-02-08.csv, SCH_Aladdin Flight Controller FC-H7_2023-02-08.json, SCH_Aladdin Flight Controller FC-H7_EasyEDA.json]
2023-04-13 3d parts
    [bottom_part_enclosure.SLDPRT, bottom_part_enclosure_3d.STL, top_part_enclosure.SLDPRT, top_part_enclosure_3d.STL]
